jongchae1977/galaxy-tab-flip-clock/images/render_exploded_back.jpg

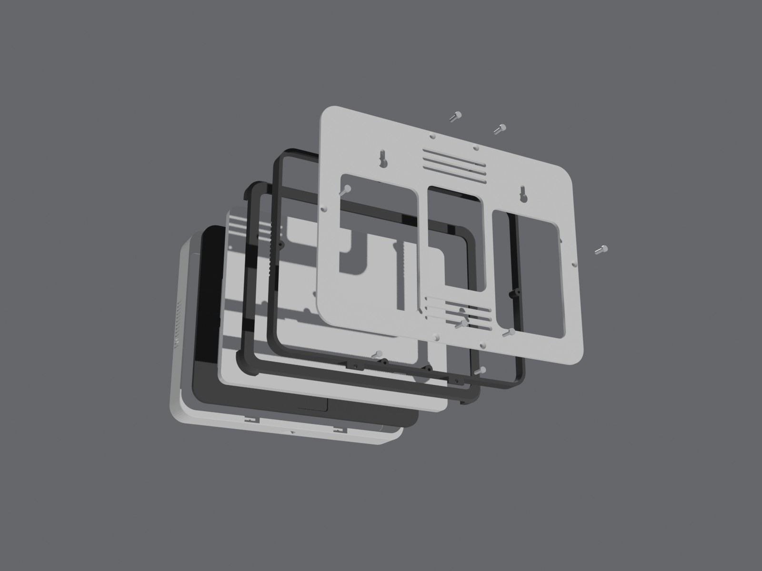
images/render_exploded_back.jpg
