jongchae1977/galaxy-tab-flip-clock/models/flip_clock_v2_full_kit.3mf

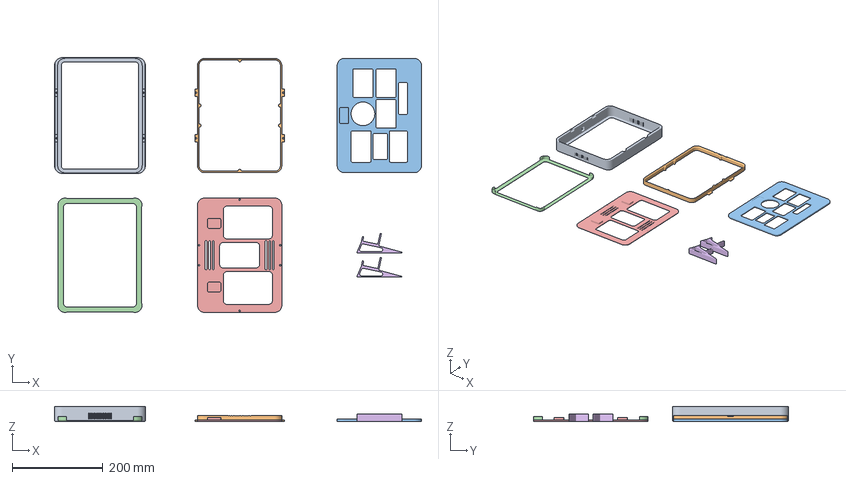
[picture p9: CAD file, 2026-10-25]
models/flip_clock_v2_full_kit.3mf
807.1 x 560.5 x 33.0 mm
Frame
Ring
Bezel
Bracket
Cover
Stand
