jongchae1977/galaxy-tab-flip-clock/models/stl/06_stand.stl

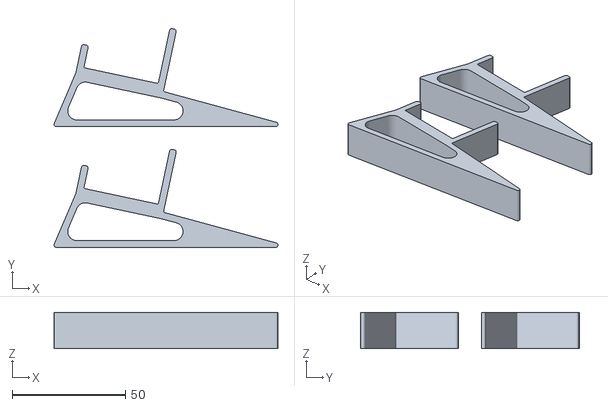
[picture p10: CAD file, 2026-10-25]
models/stl/06_stand.stl
99.0 x 96.7 x 16.0
