jongchae1977/galaxy-tab-flip-clock/models/stl/01_frame.stl

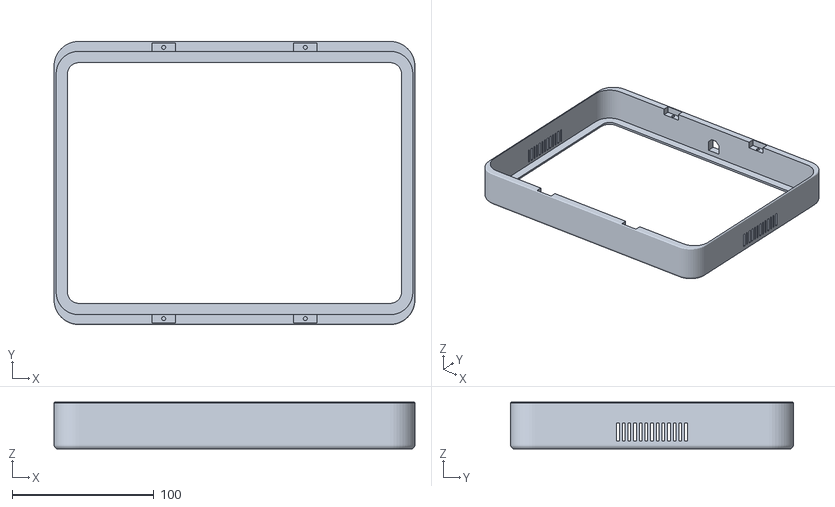
[picture p11: CAD file, 2026-10-25]
models/stl/01_frame.stl
255.0 x 200.0 x 33.0
