jongchae1977/galaxy-tab-flip-clock/models/stl/03_bezel.stl

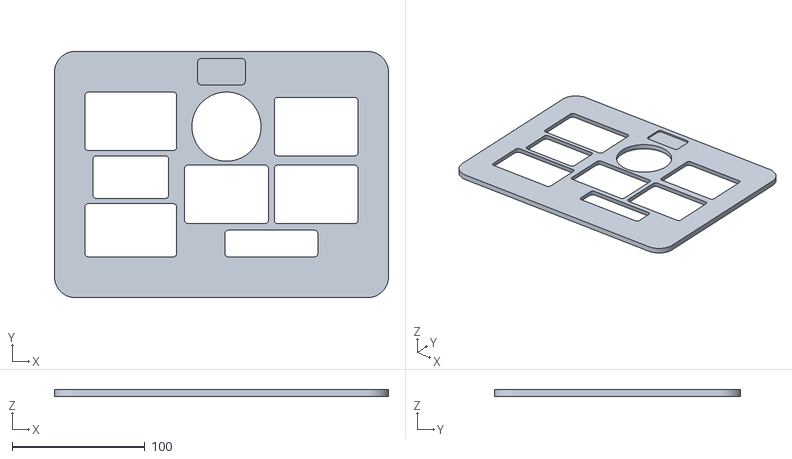
[picture p12: CAD file, 2026-10-25]
models/stl/03_bezel.stl
251.4 x 185.4 x 5.00
