jongchae1977/galaxy-tab-flip-clock/models/stl/02_ring.stl

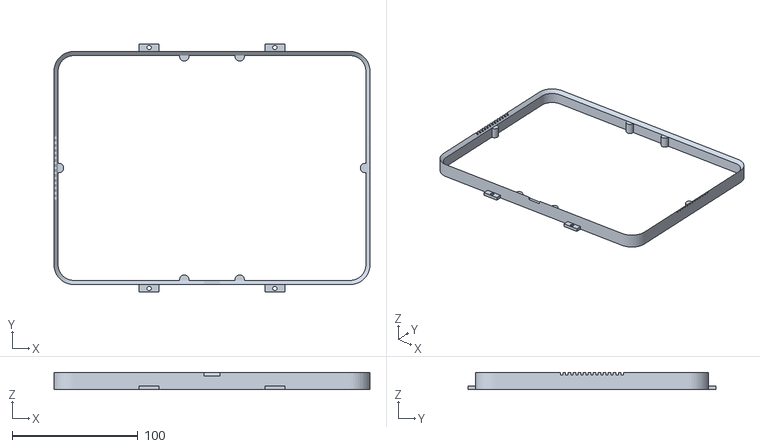
[picture p13: CAD file, 2026-10-25]
models/stl/02_ring.stl
251.4 x 197.0 x 13.6
