jongchae1977/galaxy-tab-flip-clock/models/stl/05_cover.stl

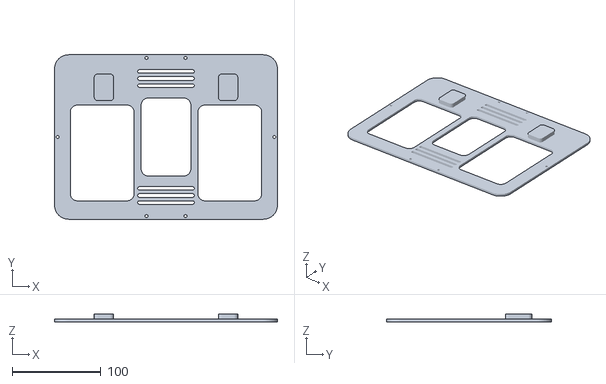
[picture p14: CAD file, 2026-10-25]
models/stl/05_cover.stl
251.6 x 185.6 x 8.50
