jongchae1977/galaxy-tab-flip-clock/models/stl/04_bracket.stl

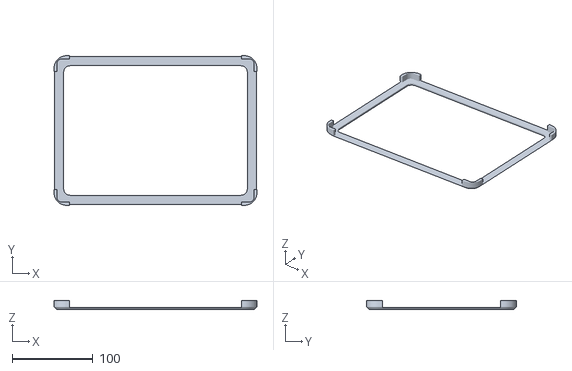
[picture p15: CAD file, 2026-10-25]
models/stl/04_bracket.stl
251.4 x 185.4 x 11.2
