jongchae1977/galaxy-tab-flip-clock/(commit log)

2026-10-25 Galaxy Tab flip clock: web app and 3D printed case
    - index.html: single-file flip calendar clock for Galaxy Tab4 (1280x800) with
    flip cards, analog clock, Open-Meteo weather/air quality, keep-awake video,
    and burn-in protection (rest-hour black screen, hourly wipe, pixel drift)
    - models/: 6-part support-free case (STL + Bambu X2D 3MF)
    - images/: photos (location metadata removed) and renders
    - Licenses: code MIT, models CC BY-NC 4.0
    [01_frame.stl, 02_ring.stl, 03_bezel.stl, 04_bracket.stl, 05_cover.stl, 06_stand.stl, flip_clock_v2_full_kit.3mf]
2026-10-26 Weather panel: bigger low/high, humidity and dust icon
    The small text rows (humidity, high/low, feels-like, dust) were unreadable
    on the tablet. The bottom of the weather panel now shows the low/high
    temperatures in place of the weather description, and below them a large
    humidity number and the dust face icon side by side.
